bokumentation/hackathon-2026-01/gds/readme.md

# gds/

Generated ASIC layout output. The hardened GDS is produced by the Tiny Tapeout
GDS GitHub Action (`.github/workflows/gds.yaml`) and is not committed to the
repository. Run `make gds` for instructions on triggering the flow.
