bokumentation/hackathon-2026-01/docs/datasheet/README.md

# Datasheet notes

Reference notes for the board and devices used in this repository.

| Document | Contents |
| --- | --- |
| [`de10-nano.md`](de10-nano.md) | DE10-Nano board facts, pin map, and source links |
