bokumentation/hackathon-2026-01/docs/identity/identity.md

## Identitas Tim
**Judul Ide Desain Chip:** TRI-ARGA: Gerbang Keamanan Data Portabel Tiga Lapis berprinsip _Fail-Closed_ untuk Tautan Serial Ringan

**Nama Tim:** Tri Arga

**Ketua:** Ibrahim Fauzi Rahman - Universitas Telkom - ibrahimfauzirahman@student.telkomuniversity.ac.id / +62 857-2774-6841
**Anggota 1:** Idris Syaifulloh - Universitas Telkom - idrissyaifulloh@student.telkomuniversity.ac.id / +62 895-3309-78461

**Dosen Pembimbing:** Dr. Setia Juli Irzal Ismail, S.T., M.T.

---

- Ibrahim Fauzi Rahman
  - Keahlian
    - Embedded Hardware/System, IoT, PCB Design, Isolated RS485/CAN Bus.
  - Peran
    - RTL: desain L1-L3 dan integrasi
- Idris Syaifulloh
  - Keahlian
    - DevOps, Machine Learning, Malware Researcher, CI/CD. 
  - Peran
    - Verifikasi: cocotb, fault injection, metrik, CI, analist.
