bokumentation/hackathon-2026-01/appendix/rf/figures/sim-boundary-timeout.png

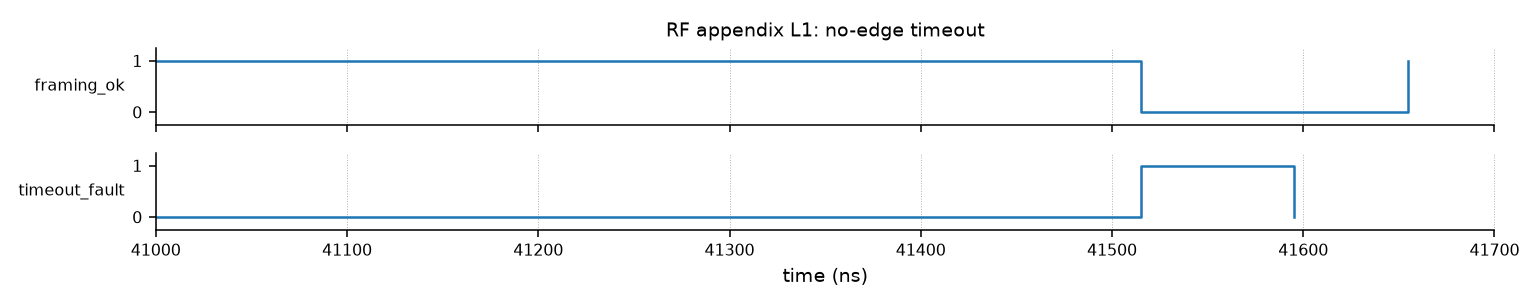
appendix/rf/figures/sim-boundary-timeout.png
