bokumentation/hackathon-2026-01/docs/deck/assets/block-diagram.png

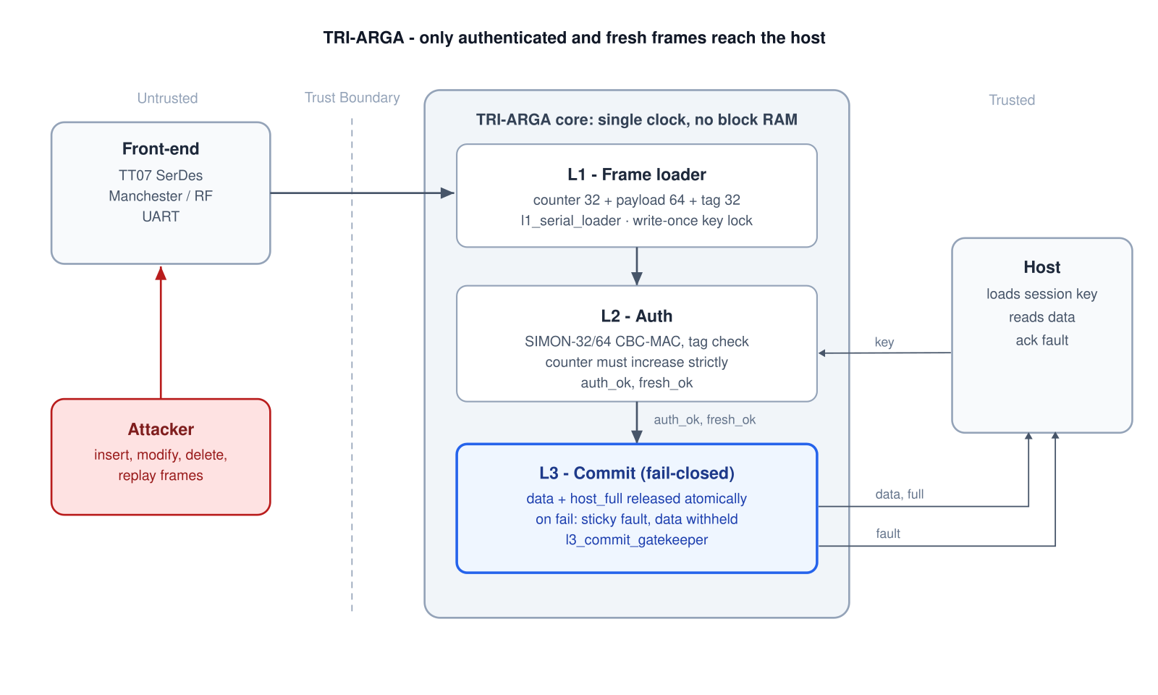
docs/deck/assets/block-diagram.png
