bokumentation/hackathon-2026-01/docs/deck/assets/frame-link.png

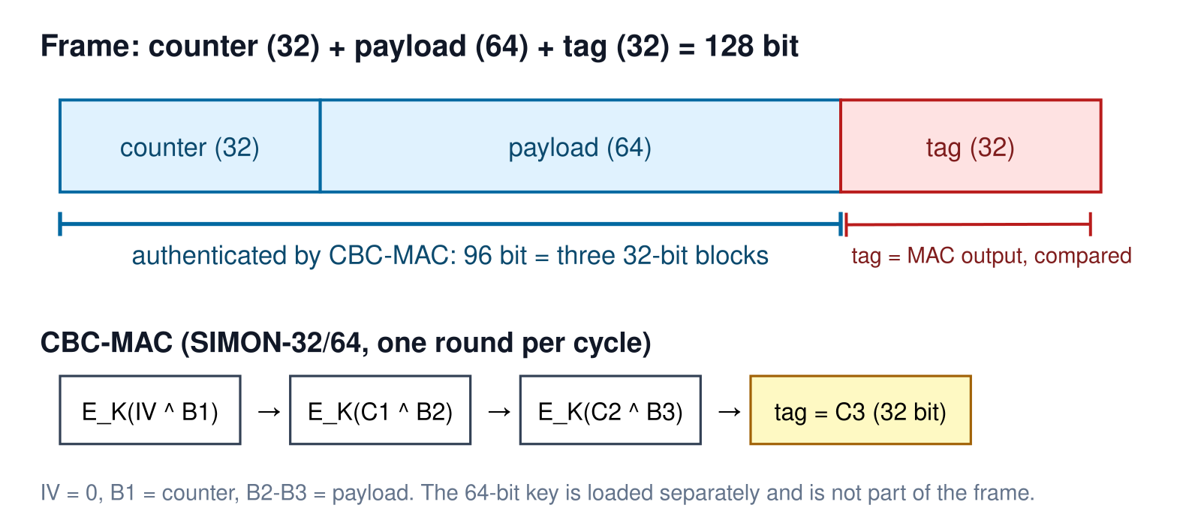
docs/deck/assets/frame-link.png
