bokumentation/hackathon-2026-01/docs/deck/assets/sim-auth-commit.png

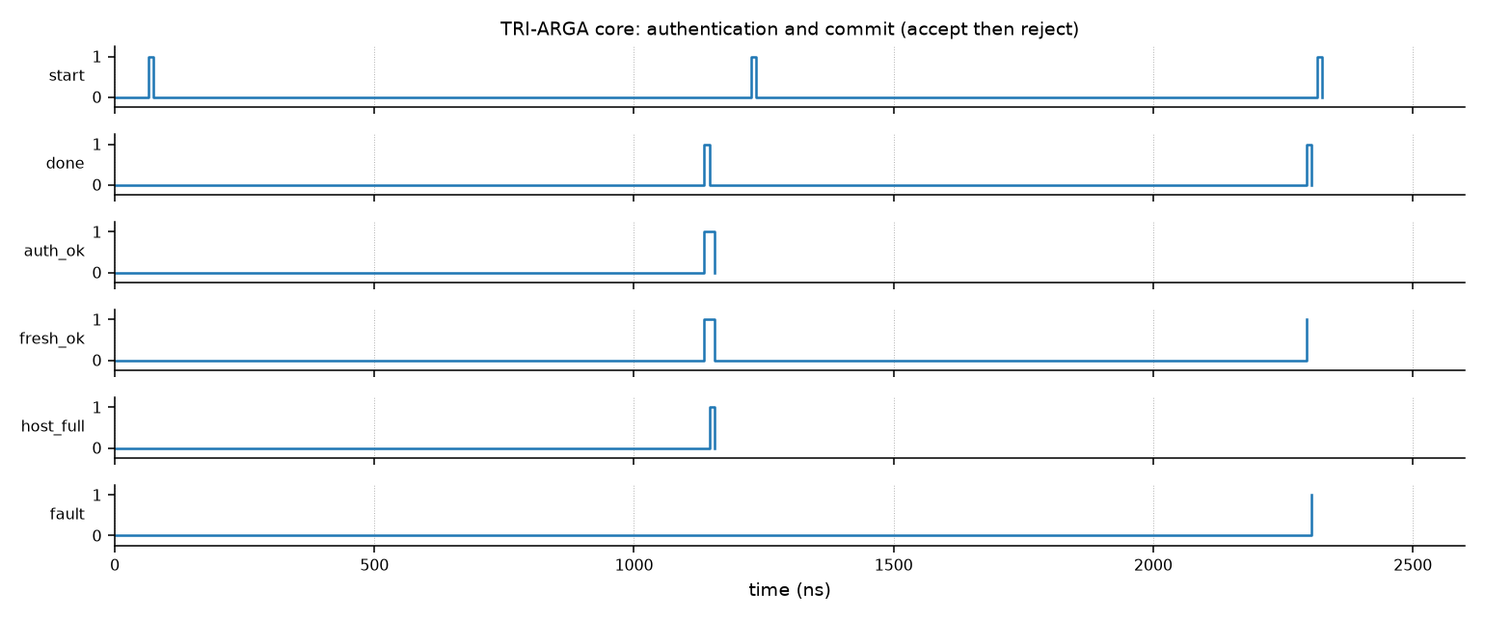
docs/deck/assets/sim-auth-commit.png
