bokumentation/hackathon-2026-01/docs/deck/assets/sim-baseline-vulnerability.png

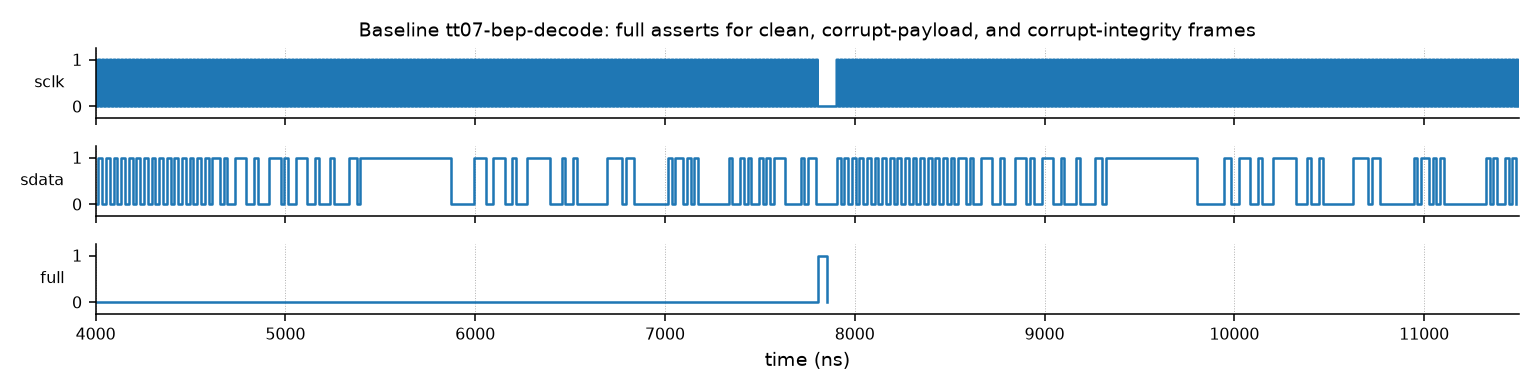
docs/deck/assets/sim-baseline-vulnerability.png
