bokumentation/hackathon-2026-01/test/tb_project.v

`default_nettype none
`timescale 1ns / 1ps

module tb_project ();

    initial begin
        $dumpfile("project.vcd");
        $dumpvars(0, tb_project);
    end

    reg clk;
    initial clk = 1'b0;
    always #5 clk = ~clk;

    reg [7:0] ui_in;
    reg [7:0] uio_in;
    reg       ena;
    reg       rst_n;

    wire [7:0] uo_out;
    wire [7:0] uio_out;
    wire [7:0] uio_oe;

    tt_um_auth_boundary dut (
        .ui_in(ui_in),
        .uo_out(uo_out),
        .uio_in(uio_in),
        .uio_out(uio_out),
        .uio_oe(uio_oe),
        .ena(ena),
        .clk(clk),
        .rst_n(rst_n)
    );

endmodule
