bokumentation/hackathon-2026-01/test/run_auth_test.py

import warnings
warnings.filterwarnings("ignore")

import sys
import os
from pathlib import Path

from cocotb.runner import get_runner

ROOT = Path(__file__).parent.parent
SRC  = ROOT / "src"
TEST = ROOT / "test"

sources = [
    SRC / "simon32_64.v",
    SRC / "l2_auth.v",
    SRC / "l3_commit_gatekeeper.v",
    SRC / "boundary_top.v",
    TEST / "tb_auth_top.v",
]

runner = get_runner("icarus")
runner.build(
    sources=sources,
    hdl_toplevel="tb_auth_top",
    includes=[str(SRC)],
    build_dir=str(ROOT / "sim_build" / "auth"),
    always=True,
)
runner.test(
    hdl_toplevel="tb_auth_top",
    test_module="test_auth_top",
    test_dir=str(TEST),
    build_dir=str(ROOT / "sim_build" / "auth"),
    results_xml=str(ROOT / "sim_build" / "auth_results.xml"),
)
