bokumentation/hackathon-2026-01/(commit log)

2026-10-05 Initial commit: hardware-enforced ingress barrier for Manchester/RF links
    Add the RTL, verification, and build infrastructure for a fail-closed hardware
    boundary that verifies frame integrity before data reaches the host.
    - RTL for L1 framing validation, L2 streaming CRC-24 verification, and
    L3 atomic commit, plus the Tiny Tapeout wrapper.
    - Pinned Tiny Tapeout 07 baseline submodules and third-party attribution.
    - cocotb testbench, Yosys synthesizability check, and SymbiYosys properties.
    - Top-level Makefile and GitHub Actions for lint, synth, formal, test, and
    the Tiny Tapeout GDS flow.
    - DE10-Nano prototype and ESP32 wired replay path.
    - Standard project files: README, CONTRIBUTING, C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
    [esp32_replay.ino, frame_capture.v, host_uart.py, l1_framing_validator.v, l2_integrity_verify.v, l3_commit_gatekeeper.v, project.v]
2026-10-05 Rework formal harness for portability and provability
    - Replace bind-based properties with explicit formal wrapper modules, which
    parse reliably across Yosys versions.
    - Constrain the initial reset sequence so the L2 and L3 invariants are provable
    from a defined initial state.
    - Split the tasks into l1/l2/l3 sby files and flatten before writing SMT2.
    [l1_formal.sv, l2_formal.sv, l3_formal.sv]
2026-10-05 Pin formal solver and include the shared header in the L1 task
    - Use smtbmc with z3 explicitly so the proof is deterministic across suites.
    - Add salaras_rx_defs.svh to the L1 [files] list.
    - Ignore SymbiYosys work directories.
2026-10-05 Add simulation evidence harness and Tier 1 results
    - sim/ with a bit-accurate frame generator, VCD waveform plotting, and
    self-checking cocotb suites.
    - Baseline evidence: tt07-bep-decode latches corrupted payload and corrupted
    integrity field with full=1 and no error (CWE-354).
    - Boundary evidence: L1/L3 accept clean frames, reject integrity and timing
    failures, hold a sticky fault, and commit in 1 cycle.
    - make sim target, sim CI workflow, and results summary in sim/RESULTS.md.
    [frame_gen.py, plot_waveforms.py, tb_boundary.v, tb_serial_baseline.v, test_baseline_vuln.py]
2026-10-05 Integrate the tt07-bep-decode front-end into SALARAS-RX
    - Vendor edge_detect, state_machine, and data_validate from the baseline into
    src/, and drive them from the synchronized digital_in.
    - frame_capture now validates the header through the baseline data_validate.
    - Retire the reimplemented manchester_rx.
    - Update info.yaml source_files, the unit test sources, and src/README.
    - Refresh synth/area.md: 1352 generic cells, 360 mapped FFs, about 508 LUT
    equivalent on Cyclone V.
2026-10-05 Record real sky130 signoff results (1x2 tile)
    - Hardened via the Tiny Tapeout GDS action (run 37273399910): die 0.0363 mm^2
    (161.0 x 225.76 um), 1233 synth cells, 0 Magic DRC, WNS 0.00, typical power
    1.21 mW; gate-level tests pass.
    - The 1x1 tile overflowed at 105.57% utilization, so the documented 1x2
    fallback is used.
    - Update synth/area.md and the proposal (ID and EN).
2026-10-05 Update repository docs for the integrated design
    - README: fix the data-flow diagram, add the sim badge, make sim/area tasks,
    add sim/ and tools/ to the layout, and add a Results section (sky130 1x2,
    0.0363 mm^2, WNS 0.00, 1.21 mW, viewer link, simulation evidence).
    - architecture/threat-model/verification-plan: integrated hierarchy, affine/ECC
    field status, 1x2 result, 1-cycle latency, l2_integrity.sby.
    - SECURITY: note that L2 is parameterized pending field reconstruction.
    - CONTRIBUTING: add make sim and make area.
    - src/README: field parameters are placeholders.
2026-10-05 Add project rules and opencode skills
    - AGENTS.md: add Project, Layout, Toolchain, RTL conventions, Verification
    gates, and Docs sections.
    - Add the salaras-rx project skill with a verify.sh helper, and the verilog-rtl
    skill.
    - Add the /verify command and the read-only rtl-reviewer subagent.
    - Track .opencode skills/commands/agents and add opencode.json.
2026-10-05 Start secure-link pivot: vision, plan, rules, and clock fixes
    [esp32_replay.ino]
2026-10-05 Add L2 authentication and freshness with measured latency
    - src/l2_auth.v: CBC-MAC over counter plus payload (three blocks) and a strict
    freshness counter, fail-closed.
    - test/test_l2_auth.py: 20 clean frames accepted, forgery, wrong key, replay,
    stale counter rejected, and 128 of 128 single-bit flips rejected.
    - Measured end-to-end MAC plus freshness latency: 107 cycles.
    - make l2 target, verify helper, results doc, and proposal latency appendix.
    [l2_auth.v, tb_l2_auth.v, test_l2_auth.py]
2026-10-05 Add integrated authentication and commit with end-to-end latency
    - src/salaras_auth_top.v: L2 wired into the shared l3_commit_gatekeeper.
    - test/test_auth_top.py: clean commit, forgery and replay rejected, sticky
    fault, commit latency 1 cycle, and a two-profile reuse test.
    - Measured Tier A end-to-end latency: 108 cycles (107 MAC plus freshness, 1 commit).
    - make auth target, verify helper, results doc, and proposal latency appendix.
2026-10-05 Add Tier A formal proofs and link area estimate
    - simon32_64.sby proves done implies rounds_done is 32.
    - auth_top.sby proves host_full implies a MAC-verified and fresh frame.
    - All five formal tasks pass (simon, auth_top, plus the RF l1/l2/l3).
    - make area-link reports the Tier A link estimate: 1280 generic cells, 500 FFs,
    360 Cyclone V LUTs.
    - Update synth/area.md, AGENTS.md, and the skill.
2026-10-05 Archive RF design under appendix/rf and retarget the repo to the link
    - Move the Manchester/RF design to appendix/rf with its own info.yaml,
    config.tcl, and README; it stays the CWE-354 problem evidence.
    - Retarget the root to the link: Makefile TOP, info.yaml, src/README, and the
    link TT wrapper (tt_um_bokumentation_auth_boundary).
    - Point the RF test, sim, and formal flows at appendix/rf/src; fix the DE10-Nano
    qsf paths.
    - Add per-test sim_build dirs and a link CI workflow.
    - Add a measured CRC latency test (73 cycles) and the CRC vs MAC vs MAC+counter
    comparison.
    - Rewrite the README and update AGENTS and both skills.
    [frame_capture.v, l1_framing_validator.v, l2_integrity_verify.v, l3_commit_gatekeeper.v, project.v, salaras_rx_top.v]
2026-10-05 Record real sky130 signoff for the link and update docs
    - Link hardened at 2x2: die 0.0756 mm^2, 2354 cells, 0 DRC, 0 LVS, WNS 0.00,
    typical power 1.87 mW.
    - Update synth/area.md, README results, and the proposal (ID and EN).
2026-10-05 Add the link DE10-Nano project and archive the RF FPGA and replay
    - New fpga/de10nano link project: salaras_auth_de10nano wrapper with the serial
    loader, SDC, QSF, Makefile, and README.
    - Move the RF FPGA project to appendix/rf/fpga/de10nano and the ESP32 Manchester
    replay to appendix/rf/replay.
    - Update README, AGENTS, and the skill for the new layout.
2026-10-05 Polish the README
    - Add the sim badge.
    - Embed the architecture and frame figures from a tracked assets/ folder.
    - Add a Status and scope section for the tiers and the appendix.
    - Complete the repository layout listing.
2026-10-05 Track the docs folder
    - Stop ignoring docs/; ignore only generated HTML (markdown and PDF are canonical).
    - Add the proposal, design, deck, judging, competition, and archive docs.
    - Update README, AGENTS, and the skill to reflect tracked docs.
2026-10-05 Fix two Tier A security vulnerabilities
    Bug 1 - CWE-1264 TOCTOU (committed data not authenticated data):
    salaras_auth_top.v passed {counter, payload} directly from input ports to
    l3_commit_gatekeeper.frame_data. If inputs changed during the ~107-cycle MAC
    computation, L3 committed data that was never authenticated. Fix: expose
    counter_q and payload_q from the latches inside l2_auth.v (cnt_lat/pay_lat)
    and wire frame_data to those latched values. Regression test
    test_inputs_changed_mid_frame_not_committed added; confirmed FAIL before fix
    and PASS after. End-to-end latency unchanged at 108 cycles.
    Bug 2 - key loaded via untrusted frame path:
    project.v and salaras_auth_de10nano.v loaded the ke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
    [auth_data_integrity.sv, l2_auth.v, project.v, run_auth_test.py, run_l2_test.py, run_project_test.py, run_simon_test.py]
2026-10-05 Tidy repo structure and rewrite README
    - Move run_*.py from root into test/ where they belong; fix ROOT path
    to ../.. so src/ and test/ resolve correctly from the new location
    - Add docs/judging/README.md index for the judging subdirectory
    - Expand docs/design/README.md to list trade-study.md and fmea.md
    - Update docs/index.md with linked table and full quick-links list
    - Rewrite README: SALARAS-RX title with team/event header, layered
    table of CWE coverage, expanded results table (formal 5+1), scope
    tiers, full repo layout tree, Windows run_*.py quick start, Security
    section with Bug 1/Bug 2 fix summary
    [run_auth_test.py, run_l2_test.py, run_project_test.py, run_simon_test.py]
2026-10-05 Add L1 serial loader module to complete the L1/L2/L3 layer model
    Extract the key-load and frame shift-in FSM from project.v and
    salaras_auth_de10nano.v into a standalone l1_serial_loader module.
    Both wrappers are now thin instantiations of L1 + L2/L3.
    - src/l1_serial_loader.v: 4-state FSM (S_LOAD/S_KEY/S_START/S_WAIT),
    64-bit key_sr with key_locked flag, 128-bit frame sr, single-cycle
    key_load and start pulses, key_locked output exposed to host
    - src/project.v: replaced inline FSM with l1_serial_loader instance;
    key_locked now routed to uo_out[2] (was unused)
    - fpga/de10nano/salaras_auth_de10nano.v: same refactor, LEDR[5] unchanged
    - synth/formal/l1_link.sby + l1_link_formal.sv: 6 BMC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
    [l1_link_formal.sv, l1_serial_loader.v, project.v]
2026-10-05 Sync proposal and README to PDF version (SALARAS final)
    Proposal ID + EN rewritten to match the PDF submission:
    - Title: SALARAS (not SALARAS-RX), subtitle added in Indonesian
    - Sec 1: results as table with sources; 3-layer solution listed explicitly
    (L1 pemuat frame, L2 autentikasi, L3 commit atomik)
    - Sec 2: split into 2.1/2.2/2.3/2.4 subsections; added RollJam reference
    and Ascon/ISO SIMON note; gap table expanded to include AEAD row
    - Sec 3.1: module table with Layer column, added l1_serial_loader.v;
    frame format table with Kunci row; CBC-MAC formula; interface table
    - Sec 3.2 (new): full threat model section with attacker capability,
    threat table, and cryptographic design decisi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
2026-10-06 Restructure docs and add Quartus and SignalTap evidence
    Docs:
    - rename proposal sources to proposal-salaras.{id,en}.md and build HTML/PDF into the git-ignored output/ with mtime-gated timestamps
    - convert the reference papers to Markdown under docs/references/ and ignore the original PDFs
    - add docs/evidence.md, docs/glossary.md, docs/demo.md, docs/submission/checklist.md
    - replace the stale proposal audit with docs/judging/submission-verification.md
    - remove docs/archive and the obsolete jury simulation and audit
    - normalize naming and standardize on SALARAS across active docs
    FPGA:
    - correct the DE10-Nano ports and pin map, add the Quartus .qpf and project fixes
    - add docs/design/quartus-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
2026-10-06 Update README with Quartus results, formal status, and setup notes
    - add measured FPGA resource, Fmax, and vector-less power rows
    - mark the ASIC signoff numbers as the pre-wrapper-fix revision
    - add a Formal verification section with the current failing status
    - refresh prerequisites, quick start, target reference, and repo layout
    - add a Documentation section linking the new docs
    - replace em dashes with hyphens
2026-10-06 Rebrand the repository to TRI-ARGA and refresh docs and evidence
    Rebrand SALARAS to TRI-ARGA across docs, skills, agents, and notices,
    and rename the design idea files. Add docs/identity/identity.md and
    update the judging, verification, and submission references.
    Replace the block diagram and frame-format figures, move the RF timeout
    figure to the appendix, and add sim/figures.sh so the simulation figures
    are reproducible from real VCDs. Update the docs CI workflow paths.
2026-10-06 Correct README formal status, CI list, and target reference
    Record that the six core formal proofs pass on the current tree while
    make formal still aborts on the non-blocking auth_data_integrity check.
    Add the link workflow to the CI list, add make figures to the quick
    start and target reference, and fix the RTL and sim layout wording.
2026-10-06 Fix the data-integrity formal proof and simplify formal CI
    Rewrite the auth_data_integrity monitor to compare the committed data
    against the inputs captured at frame start, and abstract simon32_64 in
    that job since the invariant does not depend on the cipher. The proof now
    passes (BMC depth 20) instead of failing after a long solve.
    Make make formal run every job and report a per-file result rather than
    aborting on the first failure, and drop the redundant non-blocking CI job.
    Update the formal status and job decomposition in the README, the evidence
    index, and both proposals.
    [auth_data_integrity.sv, simon32_64_stub.v]
2026-10-06 Add core framing/timing validation and close evidence gaps
    The committed loader now enforces framing validity: a truncated serial
    burst raises a sticky framing fault and a stalled auth core raises a
    timeout fault, and the commit path is gated by an explicit framing_ok
    signal rather than the MAC result alone. The RF appendix timeout evidence
    is no longer the only framing proof.
    Add a dedicated formal proof for the committed l3_commit_gatekeeper
    (l3_commit_core.sby) so the core is covered, not only the appendix. Fix
    the commit-latency test to observe host_full independently instead of
    deriving it, and make lint clean by fixing the SIMON z-index width and
    the unused signals.
    [auth_data_integrity.sv, auth_formal.sv, boundary_top.v, de10nano_top.v, l1_link_formal.sv, l1_serial_loader.v, l2_auth.v, l3_formal_core.sv]
2026-10-06 Refresh judging docs and add PERURI/INA Digital context
    Remove the stale audit, QnA, and feasibility documents, add a judging
    simulation grounded in the current repo and proposal, and record the two
    open action items. Add PERURI and INA Digital context documents as raw
    material for the product-path work.
2026-10-06 Add a progress report build and refresh docs
    Add docs/progress with a markdown source and the same HTML/PDF pipeline
    as the proposal, wired into make progress and docs-all. Update the README
    and evidence index for the framing fix and the eight formal jobs.
2026-10-06 Record the current sky130 signoff
    The GDS action ran on the framing-validated wrapper (run 37502491108,
    commit 2f91905): 2x2 tile, 0.0756 mm2, 2511 cells, 0 DRC, 0 LVS, WNS
    0.00, 2.05 mW typical, one antenna violation. Update the README, evidence
    index, area report, submission audit, and progress report. The proposal
    still needs to be updated to these numbers.
2026-10-06 Enable heuristic diode insertion to clear the antenna violation
2026-10-06 Record the antenna-clean sky130 signoff
    Re-hardened at commit 00fc423 (run 37504588955) with heuristic diode
    insertion: 0 antenna, 0 DRC, 0 LVS, WNS 0.00, 2.10 mW typical, die
    0.0756 mm2, 2511 cells. Update the README, evidence index, area report,
    submission audit, and progress report.
2026-10-06 Add the 8b/10b encoder and decoder for the serial link
    link_enc_8b10b and link_dec_10b8b implement full 8b/10b with running
    disparity, data and K characters, comma detect, and invalid-code and
    disparity-error outputs. Tables follow the standard 5b/6b and 3b/4b
    mapping. The cocotb suite checks known vectors, every data and K symbol
    across both disparity states, a 600-symbol round trip, and error
    detection.
    [link_dec_10b8b.v, link_enc_8b10b.v, tb_link_codec.v, test_link_codec.py]
2026-10-06 Add the serial link transmitter, receiver, and loopback integration
    link_tx frames a 128-bit payload as a K28.5 comma plus 16 data symbols
    with a gap-free pipelined serializer. link_rx aligns and decodes the
    symbols, reassembles the frame, and drives boundary_top with start and
    framing_ok. The decoder resyncs its running disparity on the comma. A
    cocotb loopback suite drives tx into rx through the MAC and commit core
    and checks a clean commit, a forged frame, a replay, and a line error.
    [link_dec_10b8b.v, link_rx.v, link_top.v, link_tx.v, tb_link_top.v, test_link_top.py]
2026-10-06 Record the Tier B serial-link sky130 signoff
    The link hardened at commit 9bbb2e0 (run 37511052813): 2x2, 0.0756 mm2,
    3220 cells, 0 DRC, 0 LVS, WNS 0.00, 3.61 mW typical, 2 antenna
    violations. Record it in the area report and the README results.
2026-10-07 Sync the proposal with the evidence and add the Tier B loopback demo
    - Rewrite the ID/EN proposal: hybrid structure, corrected sky130, formal, and FPGA numbers, Tier B simulation evidence, on-chip loopback test plan, and IEEE citations
    - Fit the core to six pages and move detail into the appendices
    - Add the link_demo_top FPGA wrapper with its Quartus project and measured fit, timing, and power
    - Fill the cover team contacts and correct the email domain
    - Sync README, evidence index, Quartus report, demo, SignalTap plan, and submission checklist
    [link_demo_top.v]
2026-10-07 Sync documentation with the committed Tier A and Tier B design
    - Reshape the deck into an 11-slide video-first narrative with a timed narration script for the Luaran dan Demo video
    - Rewrite src/, test/, fpga/de10nano/, and sim/ READMEs for the core plus the Tier B link
    - Rewrite the design architecture, threat model, and verification plan to the committed design and move the RF versions to appendix/rf/docs/
    - Update the FMEA with Tier B link failure modes, the trade study numbers, the glossary, the docs index, and VISION
    - Refresh the submission-verification and simulasi-penjurian audits to the current evidence
    - Update the project-workflow and verify-paper/judges skills
2026-10-07 Fix Debian setup dependencies and refresh the setup guide
    - Add build-essential to the base apt line; cocotb needs a C/C++ compiler for the VPI build
    - Add gcc and g++ to the make doctor required-tool check
    - Complete the target table with the link, figures, and docs/progress targets; correct the link vs RF appendix split
    - Replace the Yosys-proxy FPGA note with the measured Quartus results and add make link
    - Add make program / make program-link and note quartus_cpf
    - Replace the fixed known-issues list with current caveats and refresh the pointers
2026-10-07 Point Lampiran B at the source repository and drop the on-board demo line
    - Add the source repository URL to the repository bullet in the ID and EN proposal
    - State that the FPGA bitstream is buildable from this repository, and remove the bootcamp on-board demo line
2026-10-07 Fix figure regeneration, tier labels, and evidence references
    - sim/figures.sh: regenerate the baseline vulnerability figure and order the
    VCD runs so make figures rebuilds all three tracked figures
    - sim/RESULTS.md and sim/README.md: Tier A label, M1/M2/M3 sections, and
    figure paths that point at the tracked outputs
    - align the formal grouping (5 core, 1 Tier B, 3 RF) and the core test name
    across README, docs/evidence.md, PLAN.md, and docs/design/fmea.md
    - test/README.md: add the make crc suite
    - synth/area.md: refresh the generic and Cyclone V proxy estimates from a
    clean make area, label the core signoff, and pin the device capacity
2026-10-07 Untrack local personnel notes, add reference sources, and pin the DE10-Nano spec
    - stop tracking the PERURI/INA Digital personnel notes and the internal
    judging simulation; keep them local via .gitignore, and drop their links
    - add canonical source URLs to docs/references
    - use the official DE10-Nano 5CSEBA6U23I7 capacities (41,910 ALM, 166,036
    registers, 5,570 Kbits, 112 DSP, 6 PLL) in the Quartus report and the
    datasheet, sourced to Terasic and Intel CV-51001
2026-10-08 Rework proposal submission: real waveform figures, KaTeX math, trimmed references
    - add GTKWave captures for Gambar/Figure I.2 and F.1 and point the figures at them
    - render inline LaTeX with KaTeX offline (katex + marked-katex-extension, copied assets)
    - move the frame field table into Lampiran/Appendix I as Tabel/Table I.1 and fix cross-references
    - trim the reference list to the nine cited sources and renumber citations
    - update the chip title across cover, identity, README, and the progress report; render _italic_ on covers
    - replace the block diagram and frame/CBC-MAC SVGs and refresh the deck raster assets
2026-10-08 Polish README, add Tier B link evidence, and align docs
    - README: centered header, Tiny Tapeout note, Baseline section, and a four-column
    Results table (Metric, Tier A core, Tier B link, Reproduce)
    - README/NOTICE/SECURITY: submission disclaimer and limitation/cryptography notes
    - test_link_top: measure the link end-to-end latency (288 cycles) and add a
    128/128 single-bit-flip sweep through the loopback
    - align evidence and docs: sim/RESULTS M4, docs/evidence Tier B row, test/README
    counts, glossary CWE-1224, evidence 426.19 mW and 0 PLL
    - proposals: exact 426,19 mW Tier B signoff in Lampiran/Appendix H
    - refresh the top-level block-diagram and frame-link SVGs
    [test_link_top.py]
